dotnfc/arducleo/scripts/readme.txt

This folder is the main place to hold the helper scripts, projects, docs for arudcleo boards.
