dotnfc/arducleo/scripts/bins/README.txt

 all samples' bin files will be put here.
