dotnfc/arducleo/image/pcb_back.png

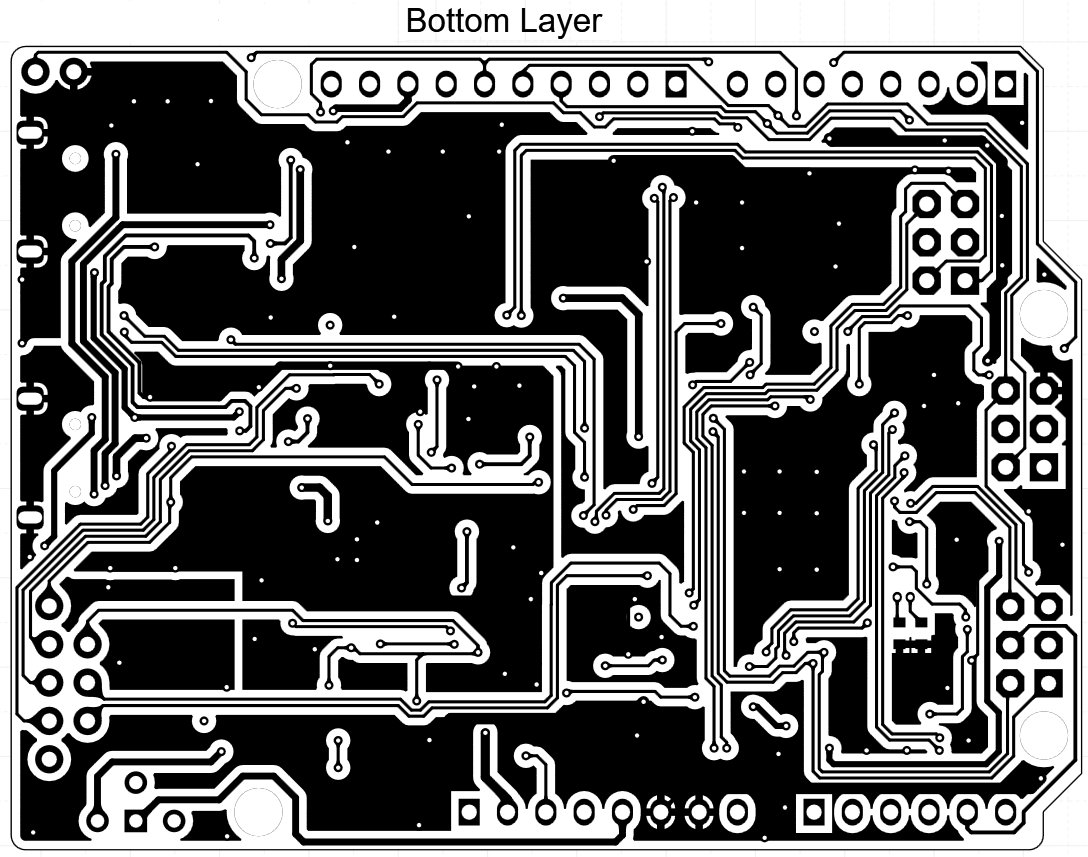
image/pcb_back.png
