dotnfc/arducleo/image/pcb_front.png

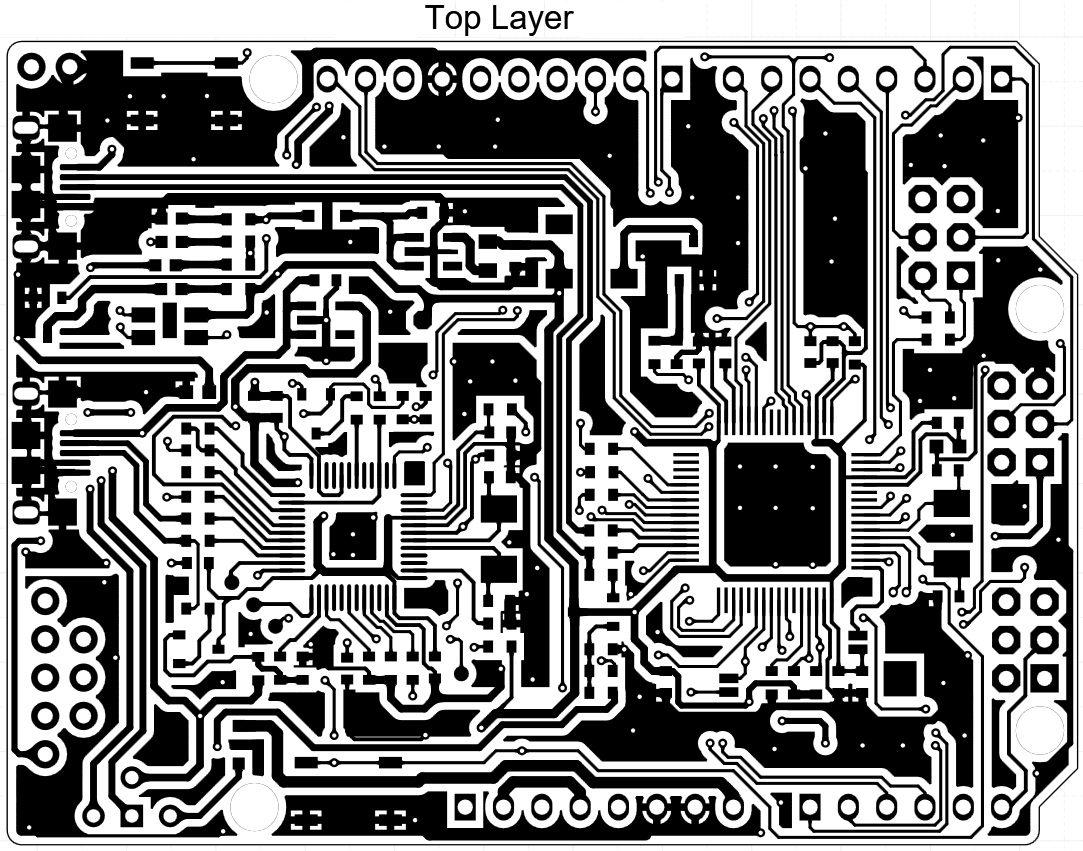
image/pcb_front.png
