dotnfc/arducleo/image/sch_back.png

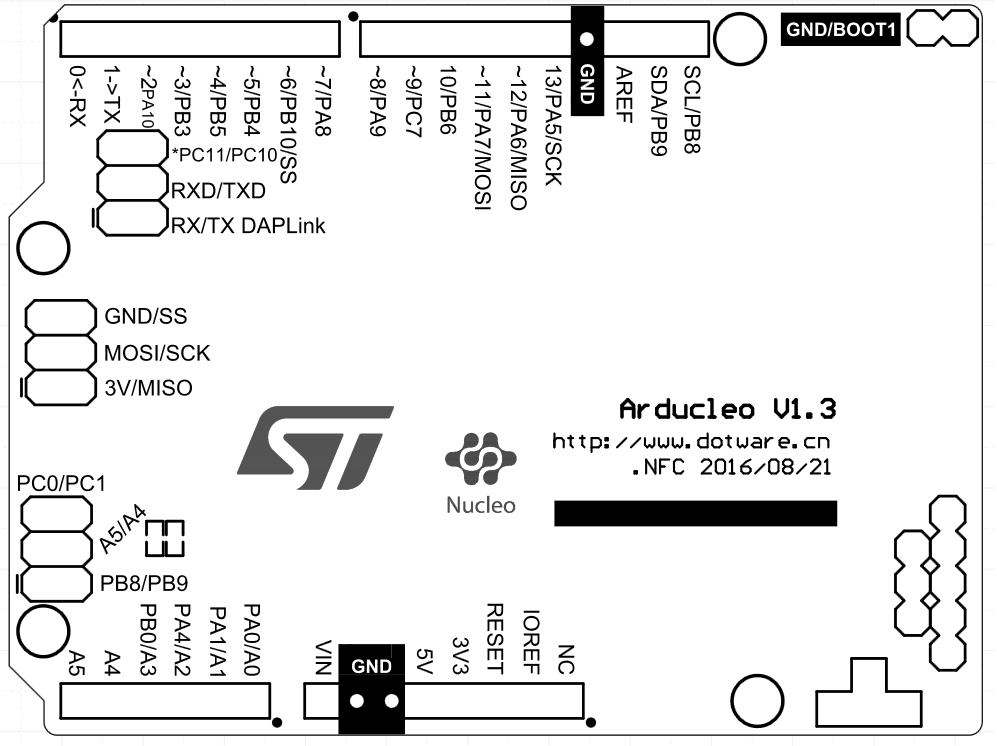
image/sch_back.png
