dotnfc/arducleo/image/sch_front.png

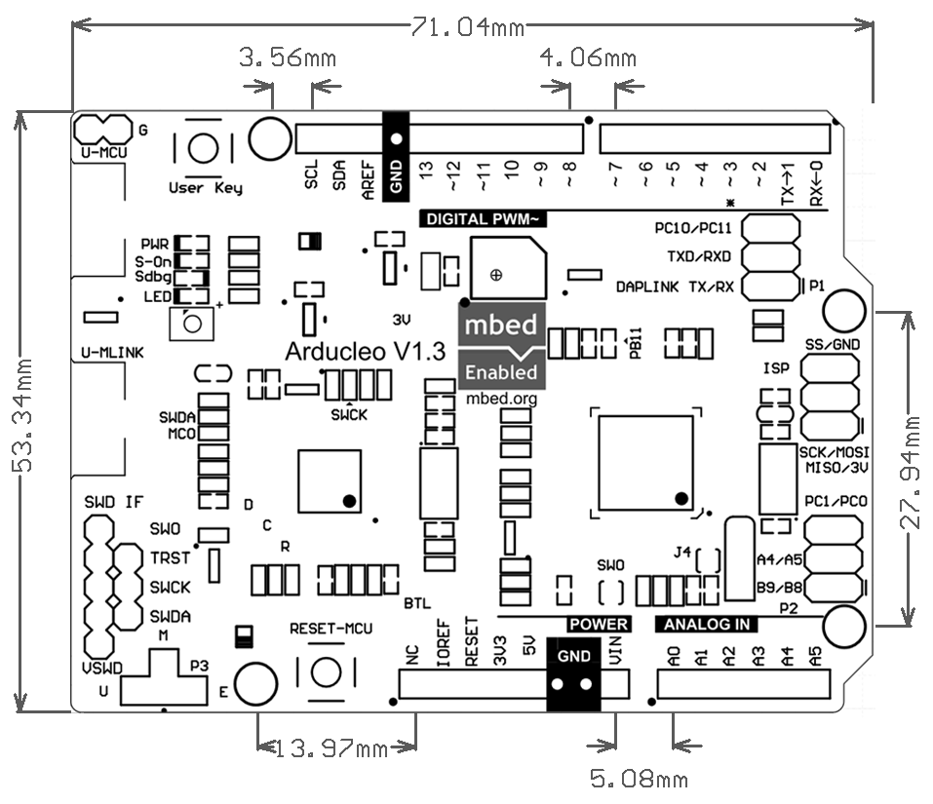
image/sch_front.png
