dotnfc/arducleo/image/snap_sch_daplink.png

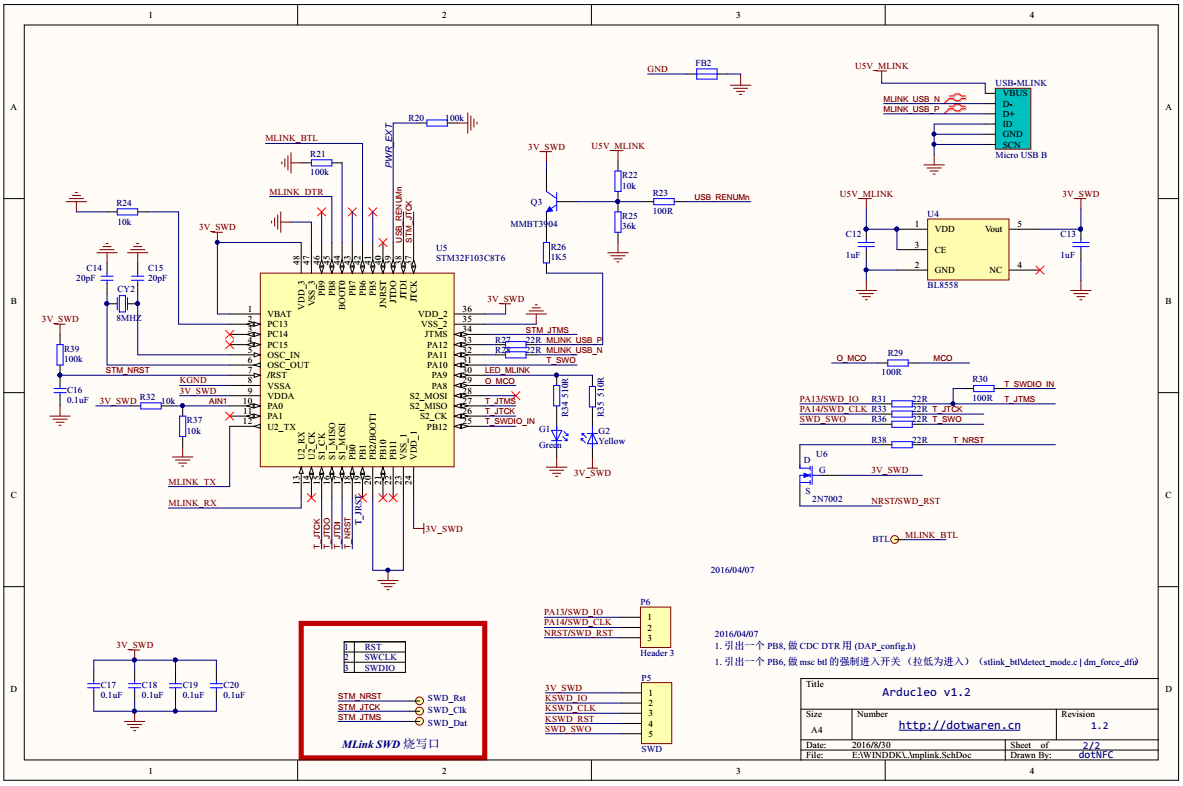
image/snap_sch_daplink.png
