dotnfc/arducleo/image/snap_sch_mcu.png

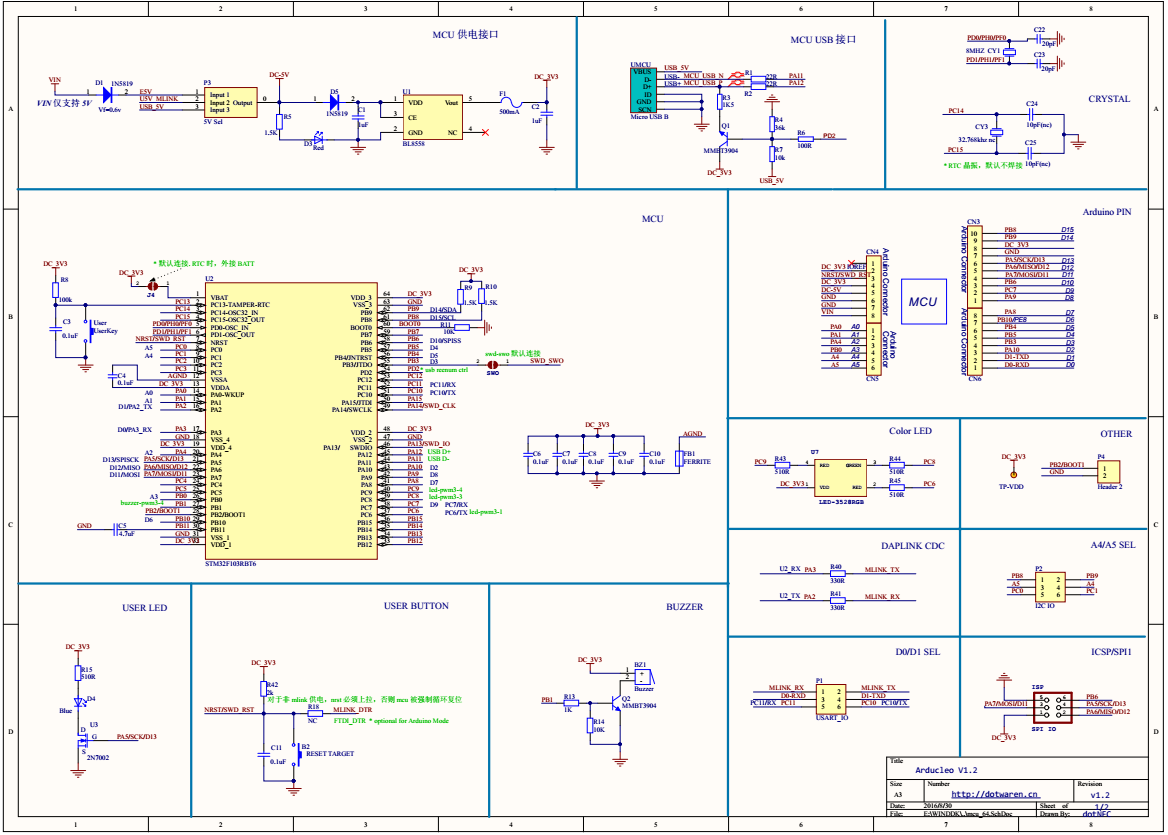
image/snap_sch_mcu.png
