dotnfc/arducleo/scripts/res/mbedclassic-homepage.png

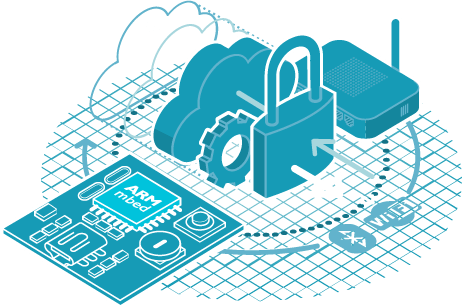
scripts/res/mbedclassic-homepage.png
