dotnfc/arducleo/scripts/res/xmbed.png

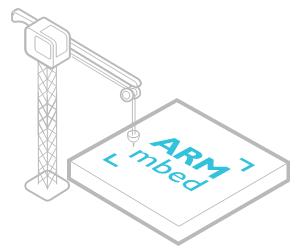
scripts/res/xmbed.png
