dotnfc/arducleo/scripts/doc/How to Use Arducleo with EmbitZ.pdf

# How to Use Arducleo with EmbitZ

by dotnfc@163.com, 2016/08/09 EmBitz (formerly Em::Blocks) is a powerful C/C++ IDE for embedded software development. In this guide, we try to use Arducleo with EmBitz.
You can download EmBitz from emblocks.org

## 1. Prepare the Embitz Debug environment

1.1 create a new file named ‘arducleo.cfg’at {embitz_installed_path}/share/contrib/openocd/scripts/board # This Arducleo board has an stm32f10x chip
source [find interface/cmsis-dap.cfg]
source [find target/stm32f1x.cfg]

1.2 Add the following line after <Board> of the openocd board setings file {embitz_installed_path}/share/EmBitz/debuggers/Interfaces/openOCD/settings.xml <arducleo file="board/arducleo.cfg" />
It looks like:

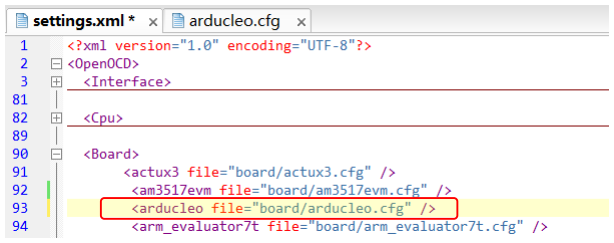
[picture p41: figure]

## 2. Export mbed project

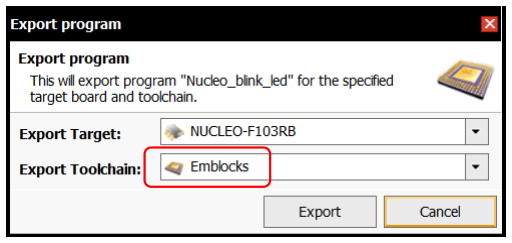
[picture p42: figure]

Once the compressed project file downloaded, you should decompress it to any location, e.g. d:\temp\Nucleo_blink_led_ebz

## 3. Import the project .ebi

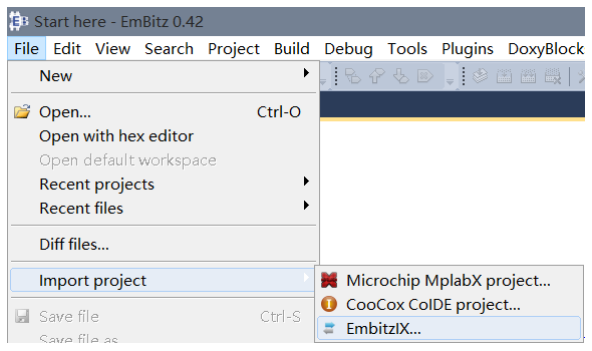
[picture p43: figure]

## 4. Modify the Project Build Settings

## 4.1 Change the GDB Server

When you prompt with the a ‘stlink | Stmicroelectronic’ dialog, close it, and change
the ‘Select interface’combbox to ‘OpenOCD’, like this:

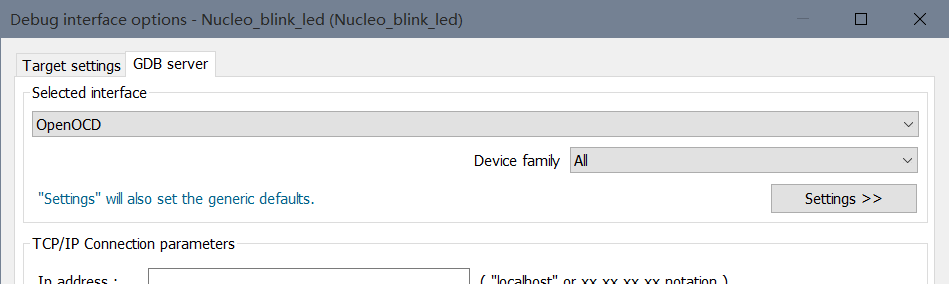
[picture p44: figure]

And click on the “Settings >>” button.

## 4.2 Change Board Settings

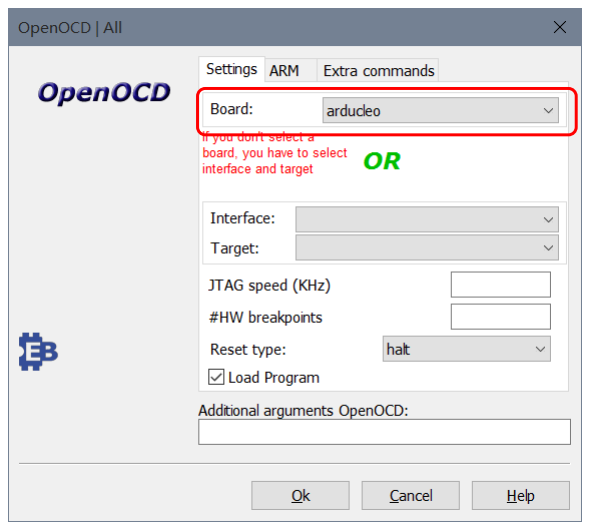
[picture p45: figure]

Select the Board ‘arducleo’, and Click Ok to save settings.

## 4.3 Change Compiler Settings

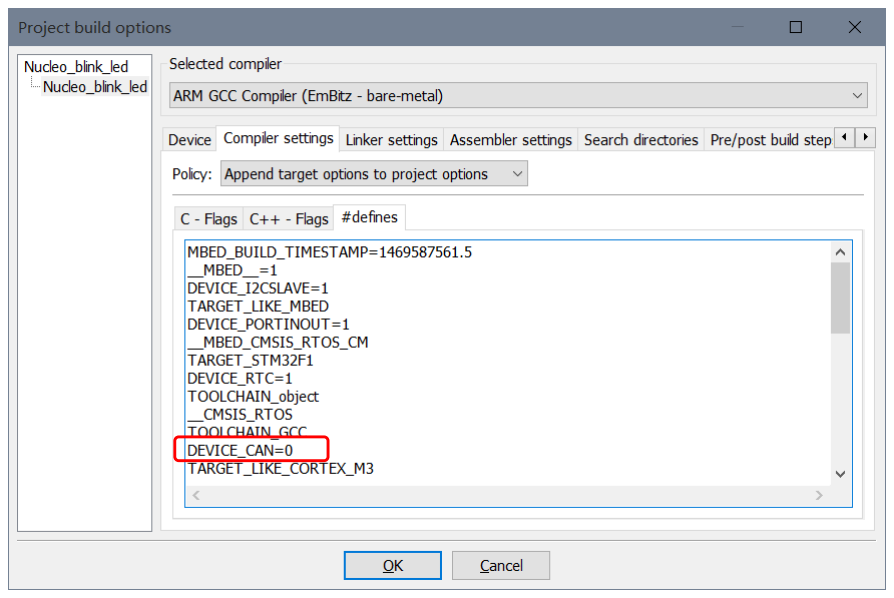
[picture p46: figure]

Turn off the CAN peripheral

## 4.4 Change Linker Settings

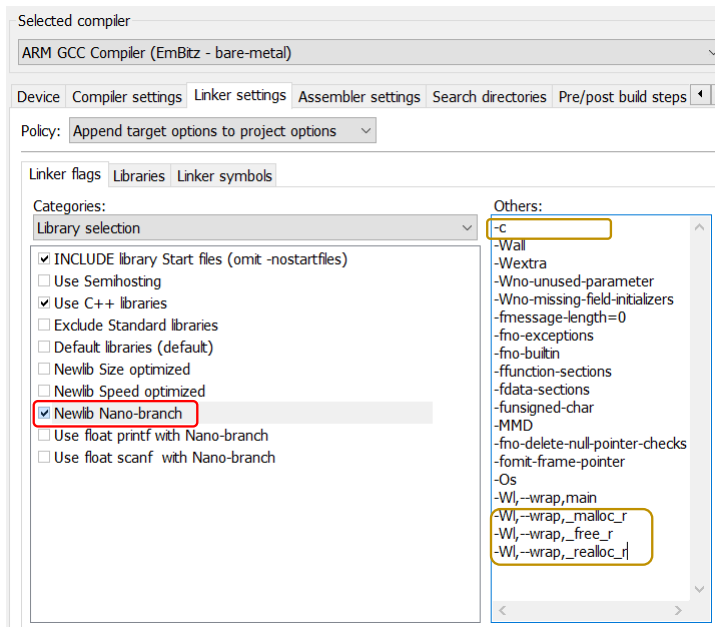
[picture p47: figure]

- Select the “Newlib Nano-branch” to reduce the program size
- Remove the “-c”” -Wl,--wrap,_malloc_r”” -Wl,--wrap,_free_r”” -Wl,--wrap,_realloc_r”flags.

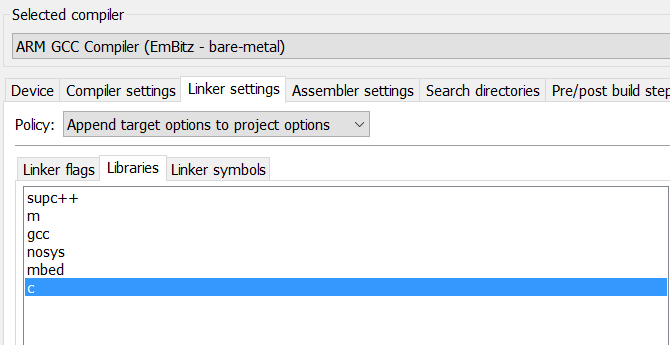
[picture p48: figure]

Move down the ‘c’ library to the end of list.

Finally, press F7 to build your mbed project; F5 to debug it.

----------------------------------------------------------- The End-----
