dotnfc/arducleo/image/snap_assemble.png

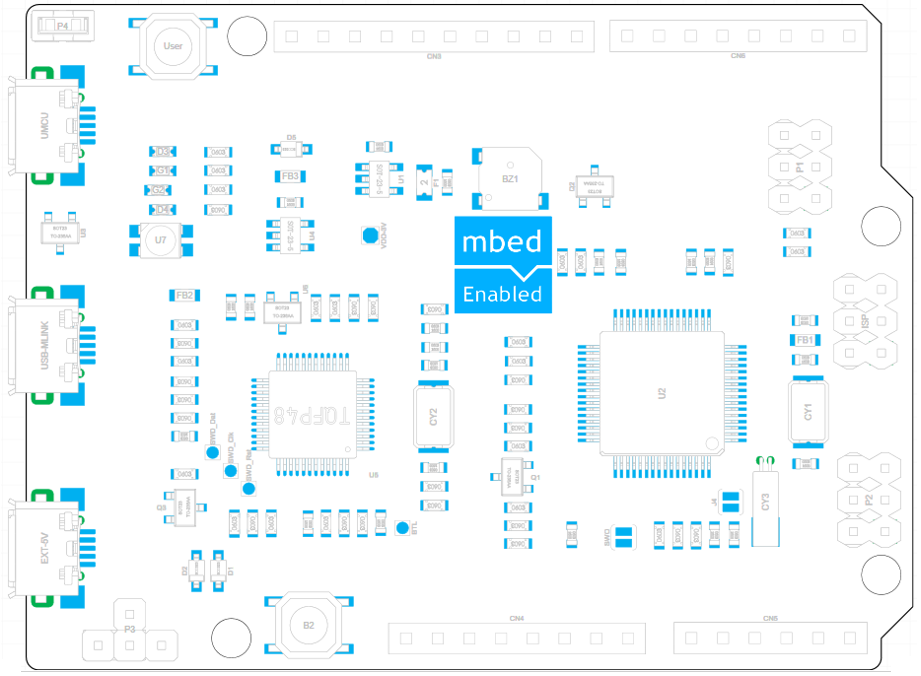
image/snap_assemble.png
