dotnfc/arducleo/scripts/doc/Arducleo_sch_rev160830_v13.pdf

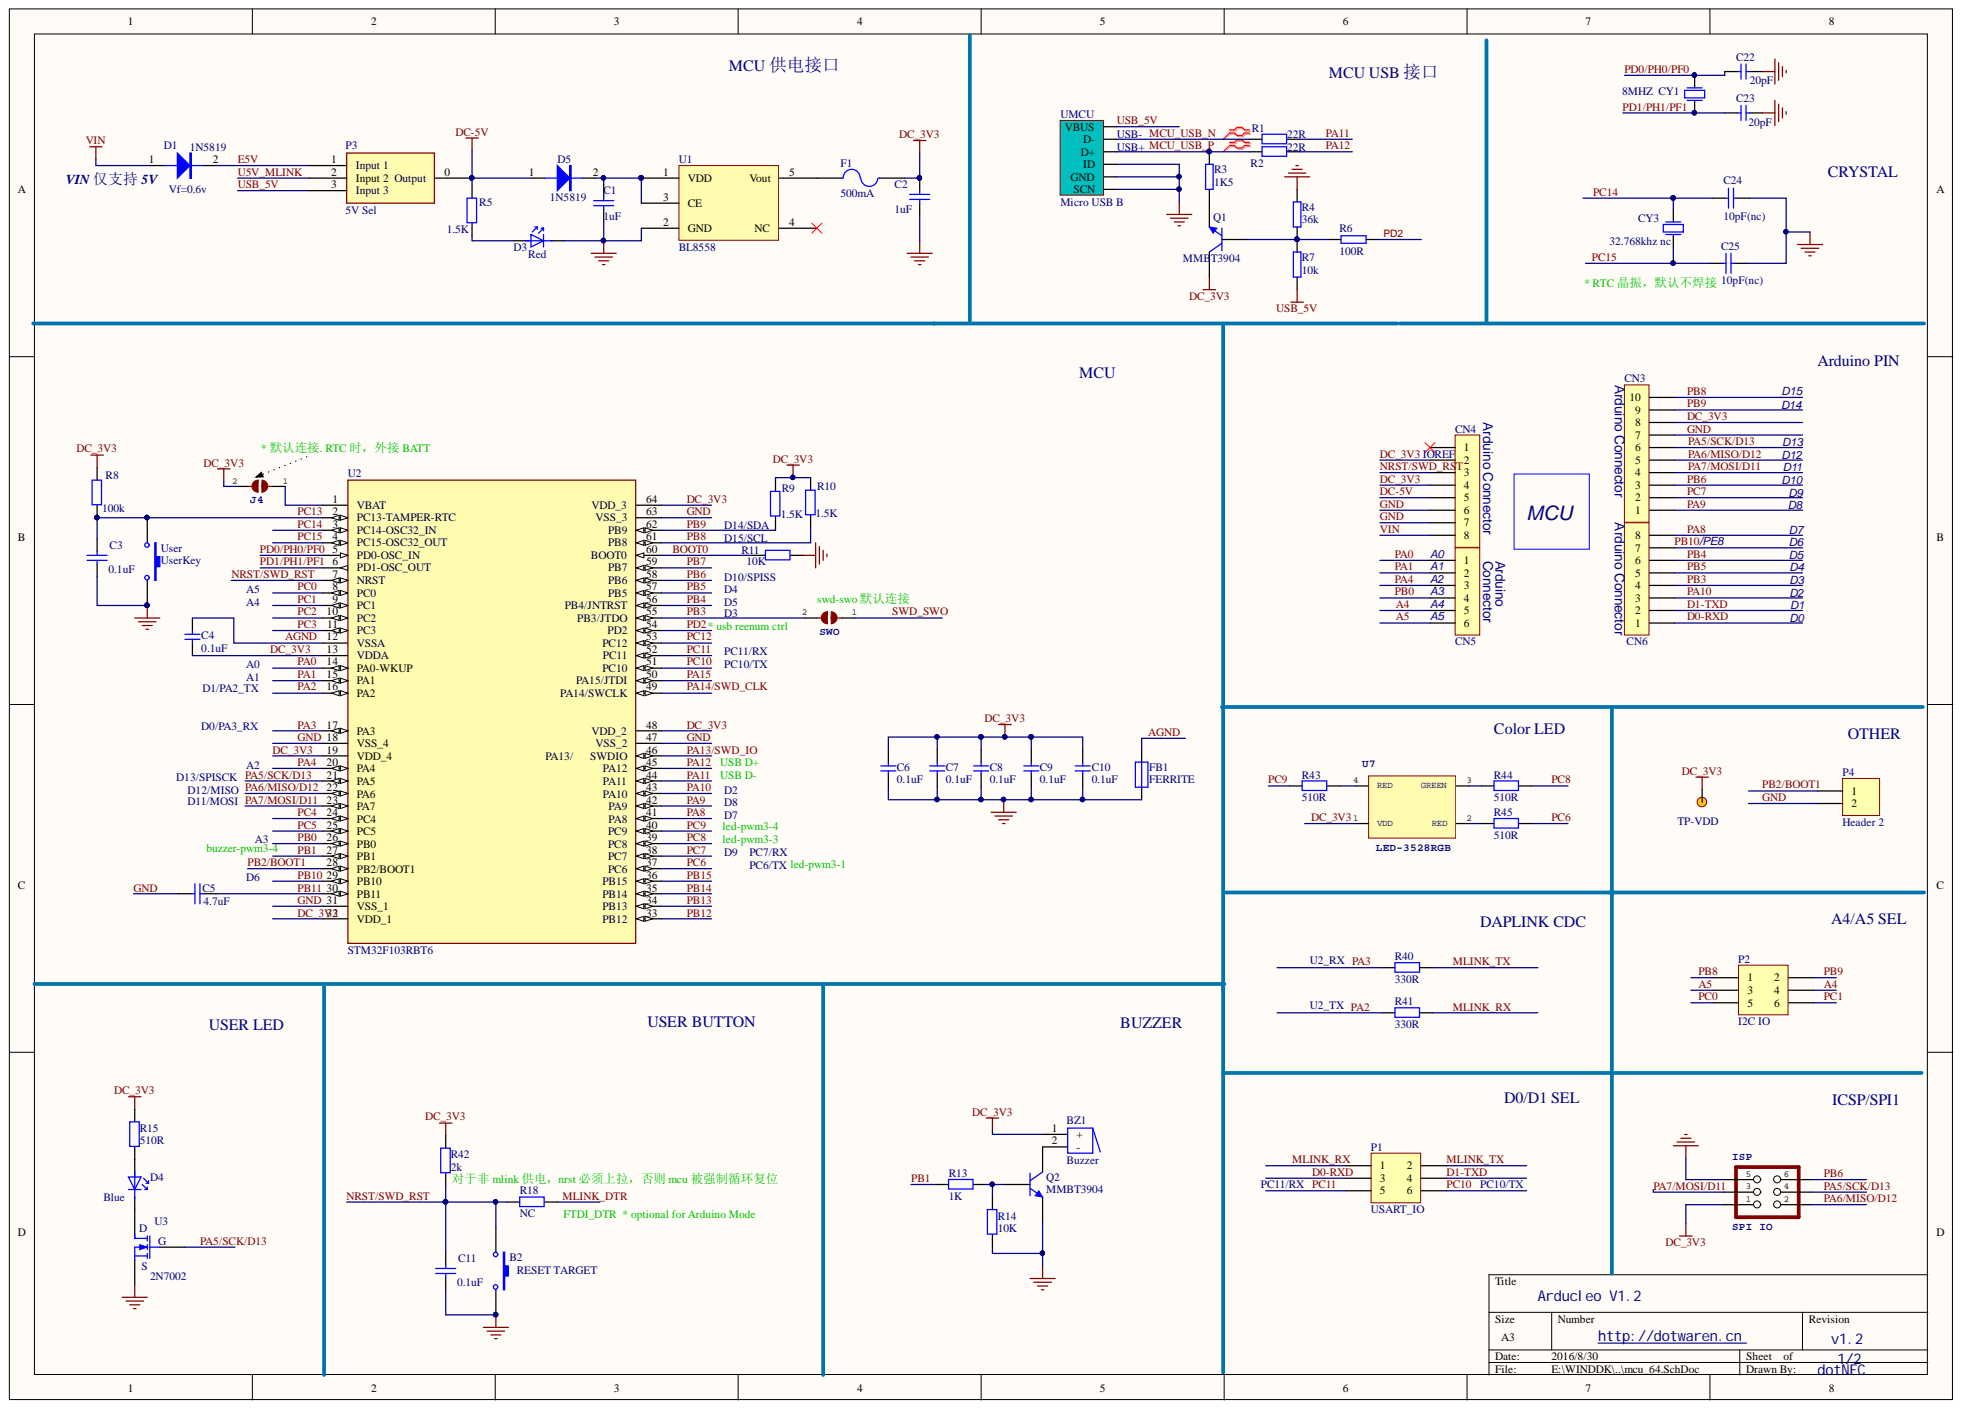
[picture p50: page 1]

rduino Connector Arduino Connector

* 默认连接. RTC 时，外接 BATT

对于非 mlink 供电，nrst 必须上拉，否则 mcu 被强制循环复位

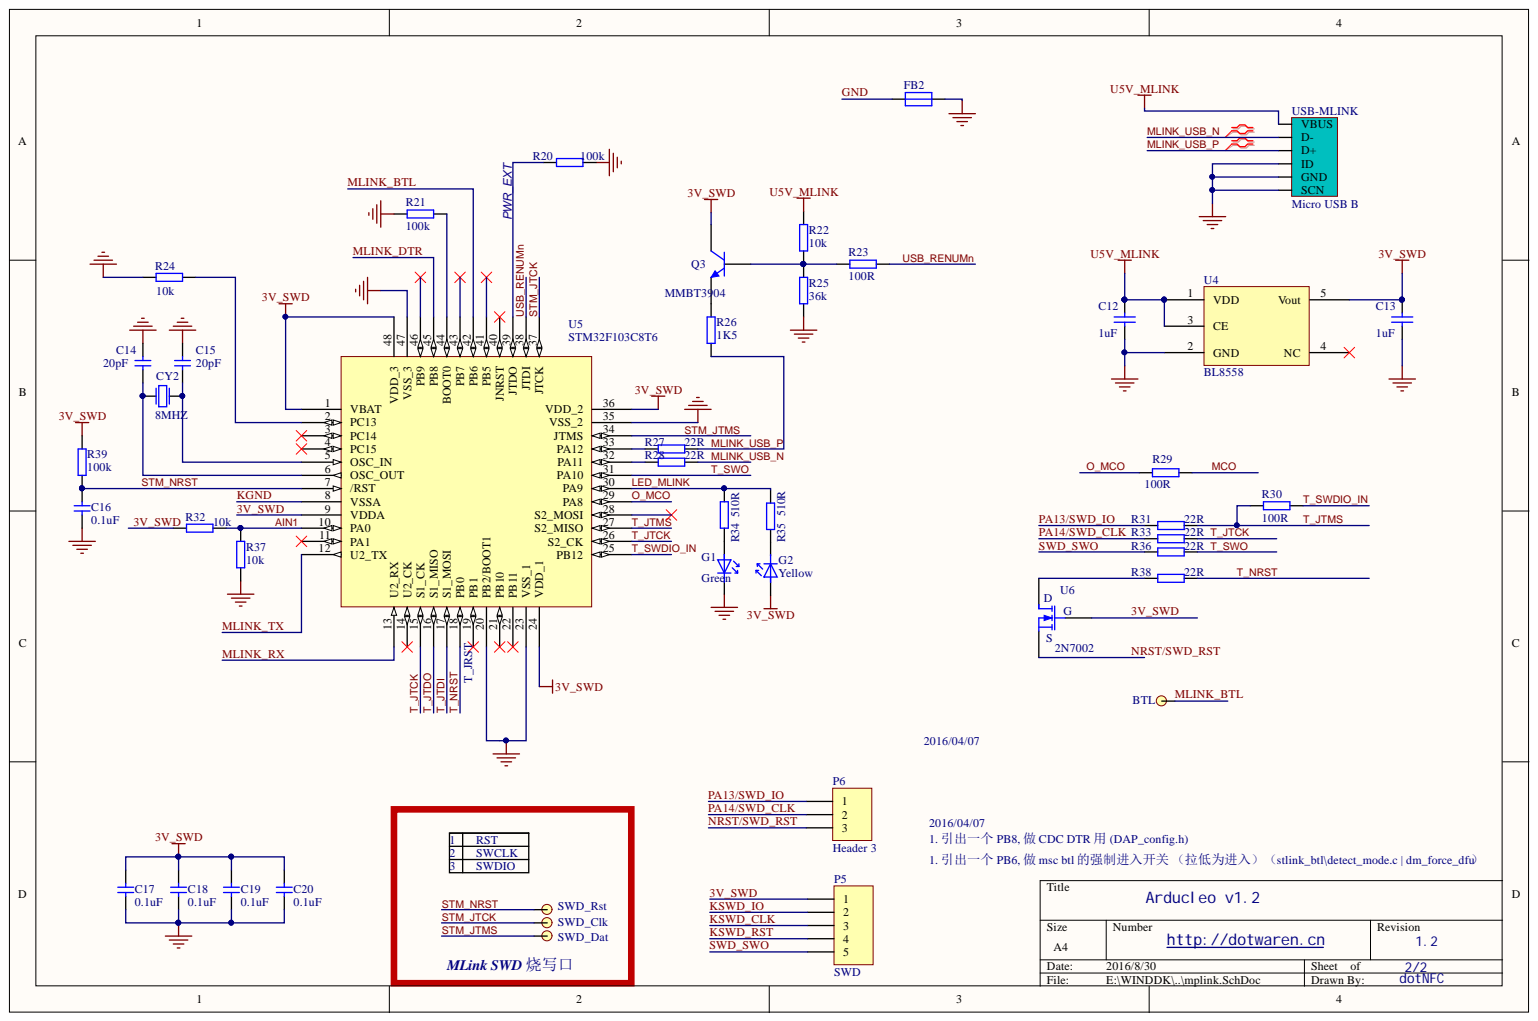
[picture p51: page 2]

JTCK 37 JTDI 38 JTDO 39 JNRST 40 PB5 41 PB6 42 PB7 43 BOOT0 44 PB8 45 PB9 46 VSS_3 47 VDD_3 48

MLINK_TX

1 | RST
2 | SWCLK
3 | SWDIO

1. 引出一个 PB6, 做 msc btl 的强制进入开关 （拉低为进入）（stlink_btl\detect_mode.c | dm_force_dfu）
