dotnfc/arducleo/scripts/samples/pwm1/pwm1_main.cpp

// Output a pwm signal.
// https://developer.mbed.org/teams/ST/code/Nucleo_pwm/
//
// Assembled by dotnfc as Arducleo Sample
// 2016/08/23


#include "mbed.h"
 
PwmOut mypwm(PWM_OUT);
 
DigitalOut myled(LED1);
 
int main() {
    
    mypwm.period_ms(10);
    mypwm.pulsewidth_ms(1);
  
    printf("pwm set to %.2f %%\n", mypwm.read() * 100);
    
    while(1) {
        myled = !myled;
        wait(1);
    }
}
