dotnfc/arducleo/(commit log)

2016-08-01 + basic scripts and samples project.
2016-08-01 update openocd, gcc-arm relative path.
2016-08-07 [arducleo-samples] add 4mhz pwm output sample.
2016-08-08 [arducleo-samples] add pwm demo: play music of mario, contra
2016-08-08 [arducleo-samples] add user manual & sch
2016-08-08 [arducleo-samples] update user manual & sch
2016-08-09 [arducleo-samples] update README.md
2016-08-09 [arducleo-samples] add new embitz doc. add a new embitz project file for blink. modify mdk project of blink.
2016-08-15 [arducleo-samples] update downloader with stlink supporting. add out-box welcome demo
2016-08-15 [arducleo-samples] adding Embitz project
2016-08-16 [arducleo-samples] update welcome code. update new uvproject. if you want to use printf ("%s"), add link flag: -u printf_float this will increase the program size. see stm32f1.mk changes.
2016-08-22 [arducleo-samples] rename contra file. improve welcome sample. there is a known bug, if turn on the color leds, buz will not work.
    [welcome_main.cpp]
2016-08-23 [arducleo-samples] change make system. supporting multi-target/platform.
2016-08-23 [arducleo samples] add new mdk projects.
2016-08-23 [arducleo samples] update mdk project
2016-08-23 [arducleo samples] mdk projects add pinnames
2016-08-25 [arducleo samples] new stm32f051k8 platform
2016-08-25 [arducleo samples] modify nano.specs
2016-08-26 Update pwm4_4mhz_main.cpp
    correct the pin info in the log message
    [pwm4_4mhz_main.cpp]
2016-08-26 [arducle samples] update target bins. and the download ui script.
2016-08-30 [arducleo] update doc/image to 1.3. add new sg90-servo sample
2016-08-30 [arducleo] add missing files
    [i2c_master_main.cpp, servo_sg90_main.cpp, spi_master_main.cpp]
2016-10-19 [arducleo] switch core to 72Mhz to generate more pules such as 12Mhz.
2018-09-01 update program with:
    - non-esc strings
    char *s1 = @"d:\temp"
    char *s2 = @[[
    //.bat
    @echo off
    dir c:\temp
    ]];
    - drag and drop functionality
